duongvanthanh2324/Esp32-Quadcopter/Electrical Schematic/Schematic_drone_2026-06-12.png

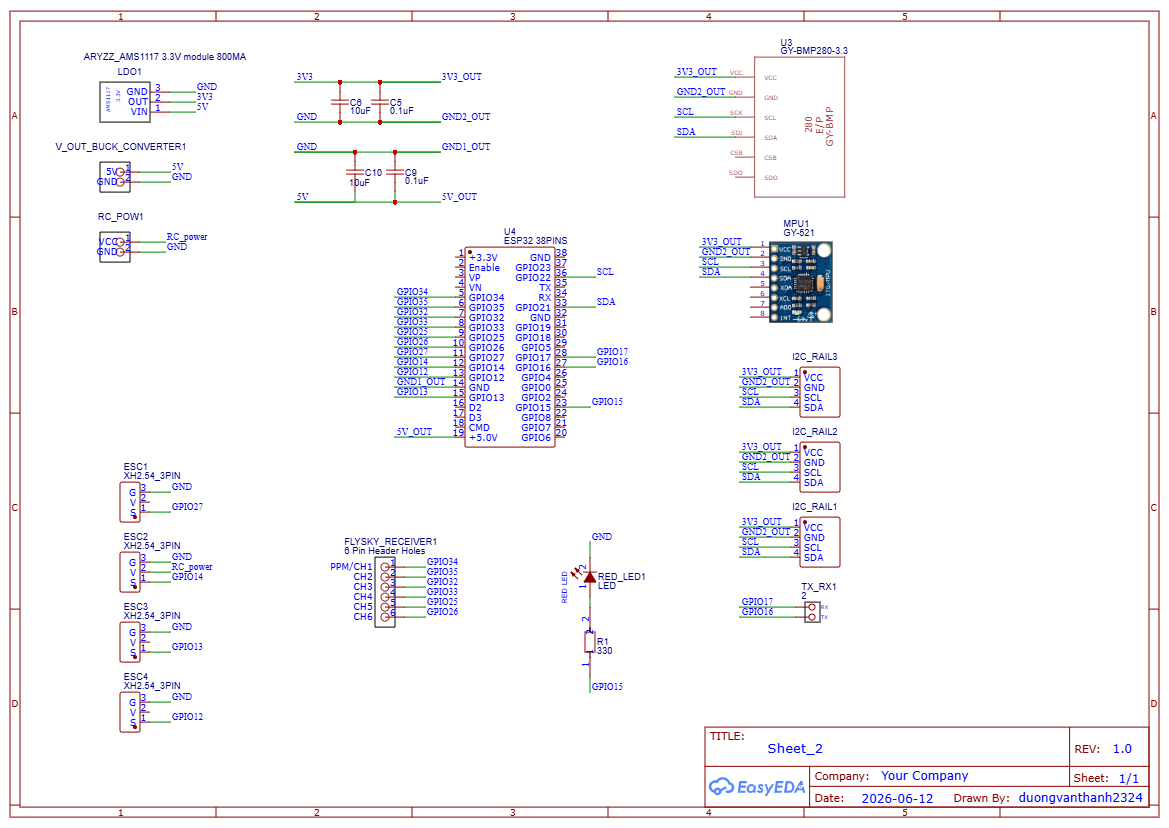
Electrical Schematic/Schematic_drone_2026-06-12.png
