duongvanthanh2324/Esp32-Quadcopter/File 3d quadcopter/arm version3_Default_sldprt.STEP

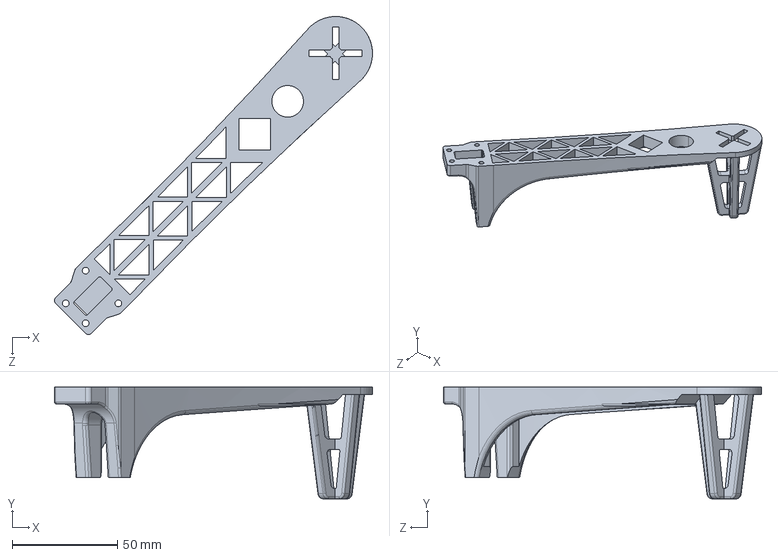
[picture p11: CAD file, 2026-06-15]
File 3d quadcopter/arm version3_Default_sldprt.STEP
151.0 x 53.0 x 151.0 mm
