duongvanthanh2324/Esp32-Quadcopter/File 3d quadcopter/lower quad 8inch _Default_sldprt.step.SLDPRT

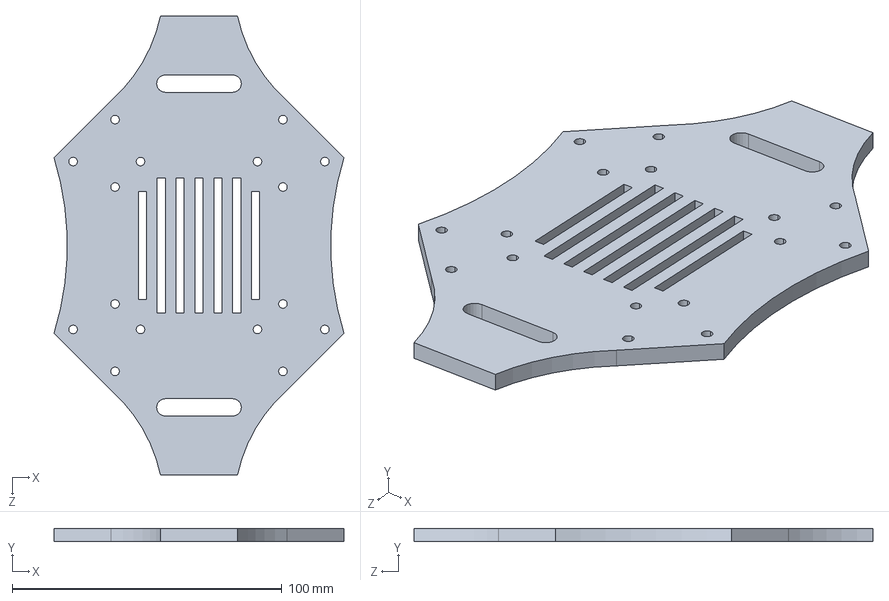
[picture p12: CAD file, 2026-06-15]
File 3d quadcopter/lower quad 8inch _Default_sldprt.step.SLDPRT
107.5 x 5.00 x 170.0 mm
