duongvanthanh2324/Esp32-Quadcopter/File 3d quadcopter/propeller 8 inch_Default_sldprt.STEP

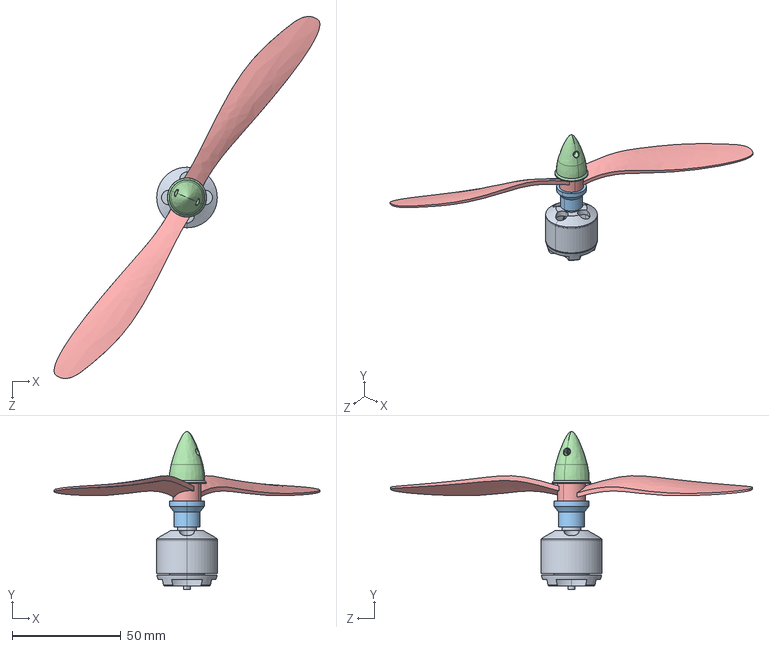
[picture p13: CAD file, 2026-06-15]
File 3d quadcopter/propeller 8 inch_Default_sldprt.STEP
122.2 x 72.8 x 166.5 mm
