duongvanthanh2324/Esp32-Quadcopter/File 3d quadcopter/upper quad 8inch_Default_sldprt.STEP

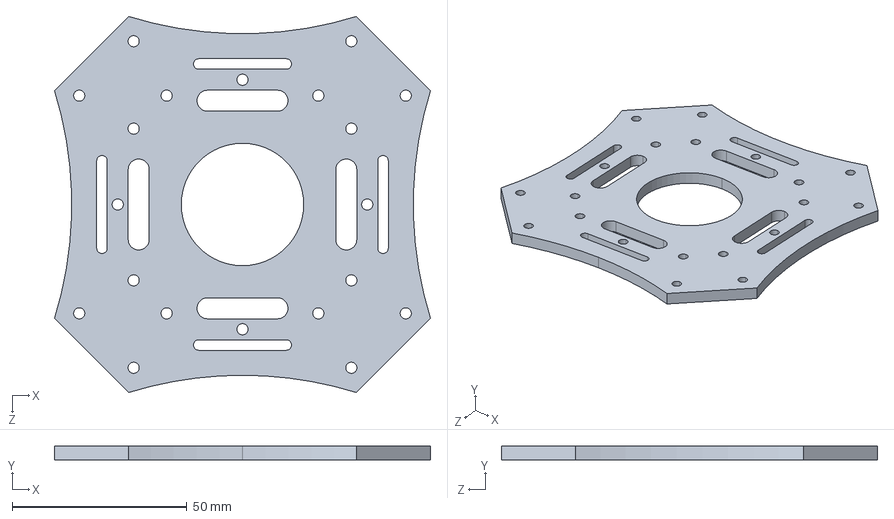
[picture p14: CAD file, 2026-06-15]
File 3d quadcopter/upper quad 8inch_Default_sldprt.STEP
107.5 x 4.00 x 107.5 mm
