duongvanthanh2324/Esp32-Quadcopter/File 3d quadcopter/quad8inch.SLDASM

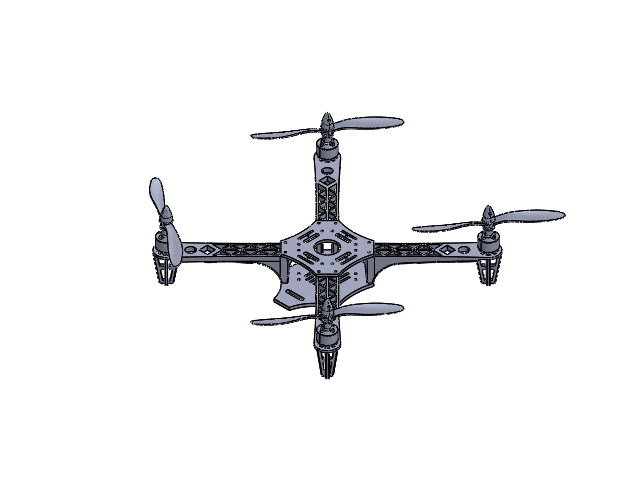
[picture p15: CAD file, 2026-06-15]
File 3d quadcopter/quad8inch.SLDASM
lower quad 8inch _Default_sldprt.step
arm version3_Default_sldprt.step x 4
propeller 8 inch_Default_sldprt.step x 4
upper quad 8inch_Default_sldprt.step
