duongvanthanh2324/Esp32-Quadcopter/(list of files, cad)

Other CAD files:
File 3d quadcopter/lower quad 8inch _Default_sldprt.STEP
