duongvanthanh2324/Esp32-Quadcopter/Electrical Schematic/PCB_PCB_drone_3_2026-06-12.pdf

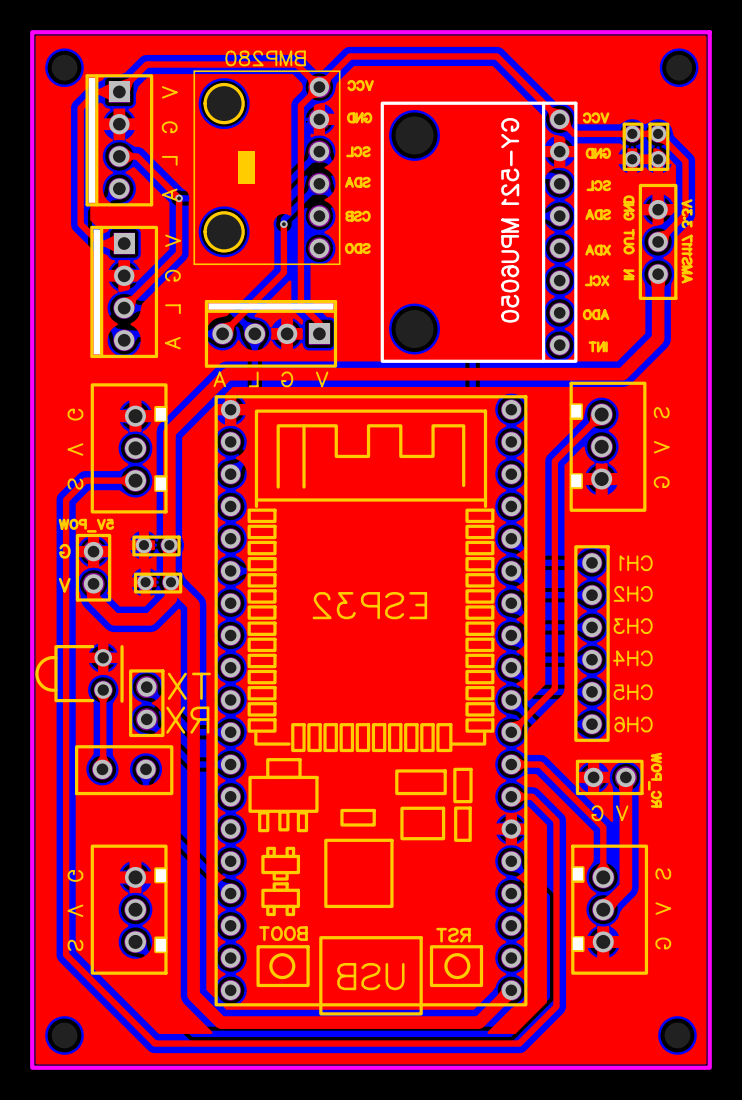
[picture p16: page 1]
