duongvanthanh2324/Esp32-Quadcopter/Electrical Schematic/Schematic_drone_2026-06-12.pdf

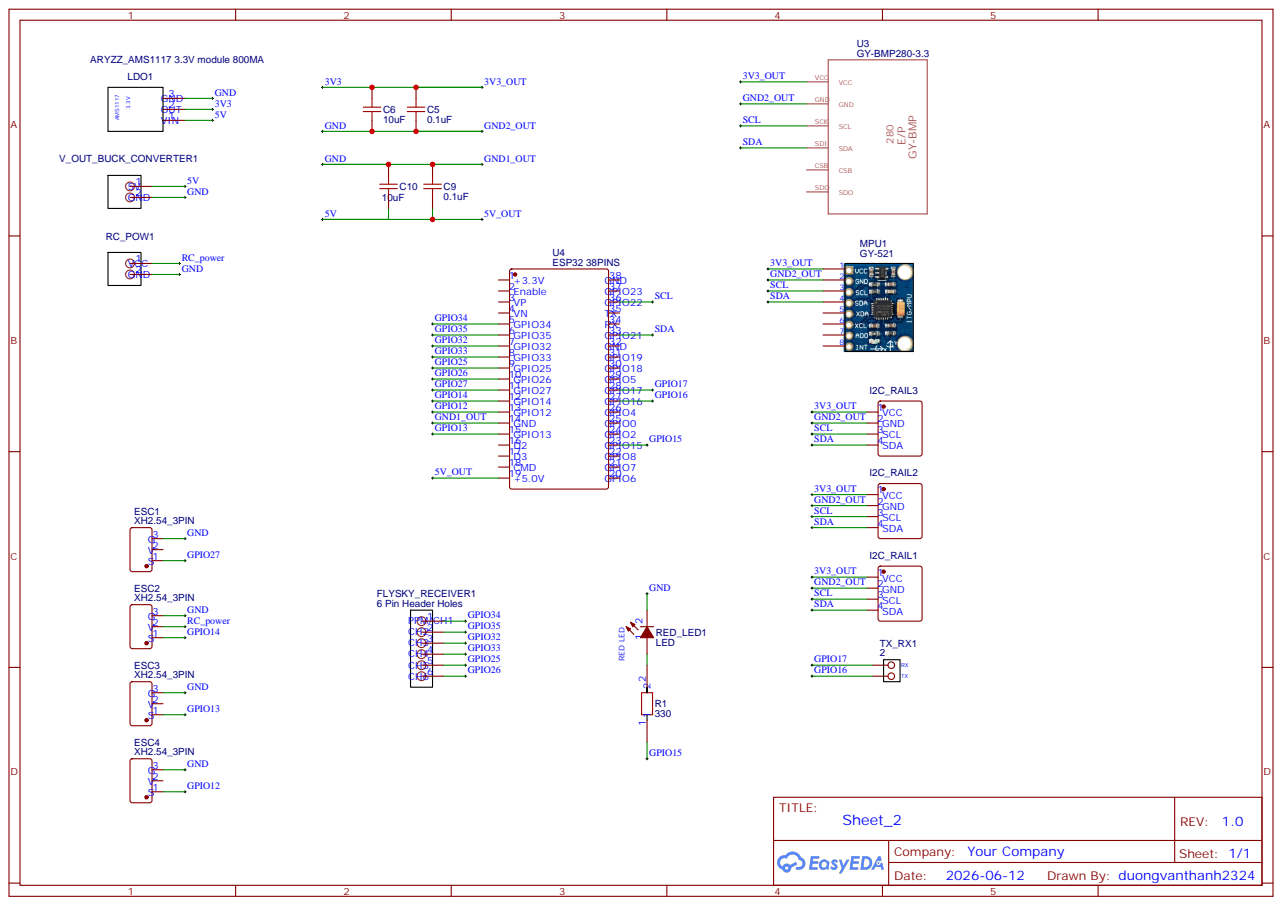
[picture p17: page 1]
