duongvanthanh2324/Esp32-Quadcopter/(commit log)

2026-06-12 Initial commit: Web dieu khien PID flight controller
2026-06-15 Add new files
    [arm version3_Default_sldprt.STEP, lower quad 8inch _Default_sldprt.STEP, lower quad 8inch _Default_sldprt.step.SLDPRT, propeller 8 inch_Default_sldprt.STEP, quad8inch.SLDASM, upper quad 8inch_Default_sldprt.STEP]
